kevinnaoko/Amplifier-Circuit/Perancangan Amplifier.pdf

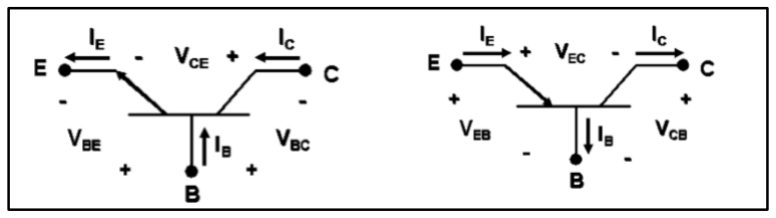
[picture p1: figure]
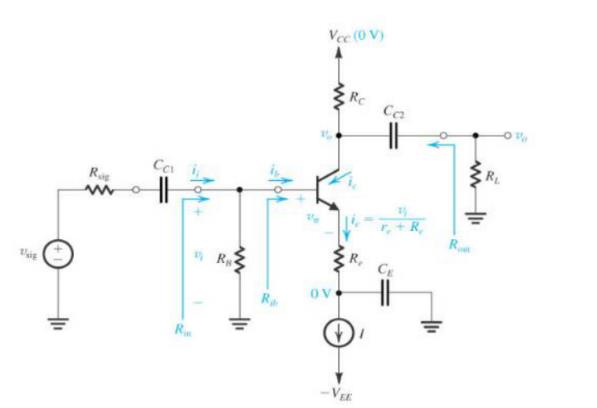
[picture p2: figure]

Laporan Praktikum - Laboratorium Dasar Teknik Elektro – STEI ITB 1

MODUL 4 DESAIN PENGUAT

Kevin Naoko (13218046)
Asisten: Moh. Tamamul Firdaus /13217062 Tanggal Percobaan: 11/03/2020 EL2205-Praktikum Elektronika
Laboratorium Dasar Teknik Elektro - Sekolah Teknik Elektro dan Informatika ITB

Abstrak

Abstrak Pada modul ini akan dilakukan perancangan desain rangkaian penguat menggunakan transistor 2N2222 dengan spesifikasi RIN = 1kΩ, ROUT = 300Ω, serta gain tanpa load = 30dB = 31.6 V/V. Pertama, dilakukan terlebih dahulu pemilihan konfigurasi penguat yang diinginkan. Kelompok ini memilih konfigurasi common emitter dengan kapasitor bypass yang diserikan dengan common emitter tanpa kapasitor bypass. Setelah dilakukan perhitungan, dilakukan simulasi di LTSpice untuk mengkonfirmasi hasil perhitungan, merangkai di breadboard, lalu merealisasikan desain di PCB. Setelah menguji rangkaian kami, didapatkan bahwa nilai RIN sesuai, ROUT melenceng menjadi 350Ω, dan gain sesuai.

Kata kunci: Desain, 2N2222, CE-CE, Gain, RIN,

ROUT.

### 1. PENDAHULUAN

Modul ini bertujuan agar praktikan dapat
merancang | sebuah | penguat | berdasarkan
pengetahuan komprehensif yang telah didapatkan pada percobaan sebelumnya. Untuk memenuhi tujuan ini, akan dilakukan prosedur percobaan sebagai berikut.

Pertama, dilakukan terlebih dahulu pemilihan konfigurasi penguat yang diinginkan. Kelompok ini memilih konfigurasi common emitter dengan kapasitor bypass yang diserikan dengan common emitter tanpa kapasitor bypass. Setelah dilakukan perhitungan, dilakukan simulasi di LTSpice untuk
mengkonfirmasi | hasil | perhitungan, | akan
dilanjutkan dengan pembelian komponen yang diperlukan di Anam Electronics, dan membuat rangkaian purwarupa di breadboard. Setelah dikonfirmasi di breadboard, praktikan perlu mendesain PCB dengan software Eagle, lalu mencetak PCB tersebut dan merangkai rangkaian akhir di PCB dengan komponen yang telah dibeli. Dan terakhir, akan dilakukan pengujian untuk terakhir kalinya terhadap nilai RIN, ROUT, dan gain dari rangkaian.

### 2. STUDI PUSTAKA

### 2.1 TRANSISTOR BJT

BJT ialah semikonduktor yang menggunakan elektron dan hole charge carriers. Pada umumnya,

BJT digunakan sebagai amplifier [1]. Terdapat dua jenis BJT, yaitu jenis NPN dan PNP. Notasi dari kedua jenis BJT tersebut dapat dilihat dibawah ini.

Gambar 2-1 (kiri). BJT tipe NPN [1] Gambar 2-2 (kanan). BJT tipe PNP [1]
BJT memiliki 3 kaki yang dilabel sebagai B, E, dan
C. Ketiga kaki tersebut memiliki arus yang saling
berhubungan | secara | matematis. | Hubungan
tersebut dapat dilihat dibawah ini [2]
| β = IC IB | ; β = α 1 − α
| α = IC IE | ; α = β β + 1

Pada modul ini, akan digunakan BJT bertipe NPN dalam rangkaian penguat.

### 2.2 PENGUAT COMMON EMITTER

Konfigurasi ini memiliki resistansi input yang sedang, transkonduktansi yang tinggi, resistansi output yang tinggi dan memiliki penguatan arus dan tegangan yang tinggi. Konfigurasi ini dapat dilihat pada gambar dibawah ini

Gambar 2-3. Rangkaian CE dengan RE [1]

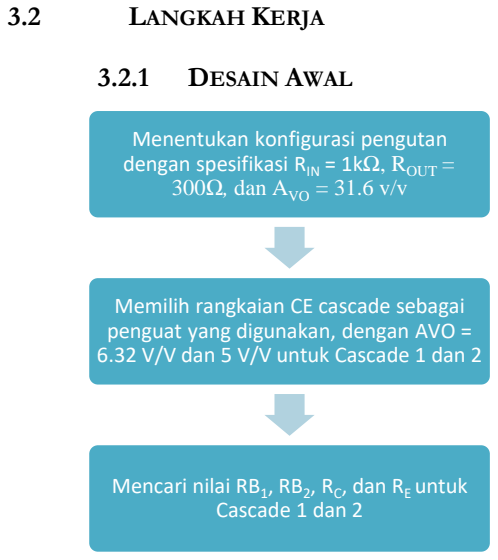
[picture p3: figure]
3.2 LANGKAH KERJA; 3.2.1 DESAIN AWAL; Menentukan konfigurasi pengutan dengan spesifikasi RIN = 1kΩ, ROUT = 300Ω, dan AVO = 31.6 v/v; Memilih rangkaian CE cascade sebagai penguat yang digunakan, dengan AVO =; Mencari nilai RB1; , dan RE untuk Cascade 1 dan 2
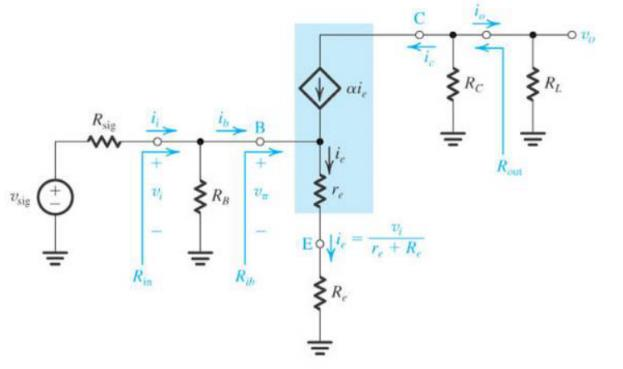
[picture p4: figure]
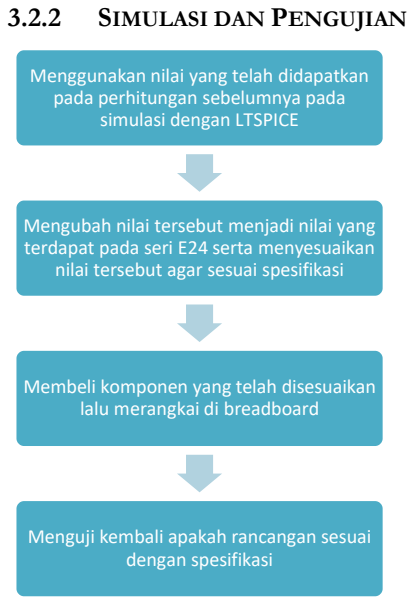
[picture p5: figure]
3.2.2 SIMULASI DAN PENGUJIAN; Menggunakan nilai yang telah didapatkan pada perhitungan sebelumnya pada simulasi dengan LTSPICE; nilai tersebut agar sesuai spesifikasi; Membeli komponen yang telah disesuaikan lalu merangkai di breadboard; Menguji kembali apakah rancangan sesuai dengan spesifikasi

Laporan Praktikum - Laboratorium Dasar Teknik Elektro – STEI ITB 2

Analisis DC

Dari KVL dan KCL, dapat diturunkan beberapa rumus umum sebagai berikut

VE = RE ∙ IE ≈ RE ∙ IC

VB = VE + VBE

VRB1

VRB2

=

RB1

RB2

Analisis AC

Untuk melakukan analisis AC, rangkaian dapat diubah menjadi rangkaian model T seperti gambar dibawah, untuk mencari besaran seperti Rin, Rout, AVO, dsb

Gambar 2-4. Model π dari gambar 2-2 [2]
Dari gambar 2-3, dapat dicari beberapa besaran dibawah ini [2]

re =

VT
IE

=

∝ VT
IC

RB2 ≤

β ∙ RE
re

AVO =

RC
RE + re

IC =

VCC − VCE
RE + re

RIN = RB1

||RB2

||re

Ro = RC

### 3. METODOLOGI

### 3.1 KOMPONEN DAN ALAT

1. Sumber Tegangan DC
2. Generator Sinyal
3. PCB
4. Resistor 100Ω (4 buah)
5. Resistor 150Ω (4 buah)
6. Resistor 1kΩ (1 buah)
7. Resistor 1.2kΩ (1 buah)
8. Resistor 1.5Ω (1 buah)
9. Resistor 3kΩ (1 buah)
10. Resistor 3.3kΩ (1 buah)
11. Resistor 12kΩ (1 buah)
12. Kapasitor 10µF (1 buah)
13. Transistor 2N2222 (1 buah)
14. Kabel Jumper (4 buah)

6.32 V/V dan 5 V/V untuk Cascade 1 dan 2

Mengubah nilai tersebut menjadi nilai yang terdapat pada seri E24 serta menyesuaikan

Laporan Praktikum - Laboratorium Dasar Teknik Elektro – STEI ITB 3

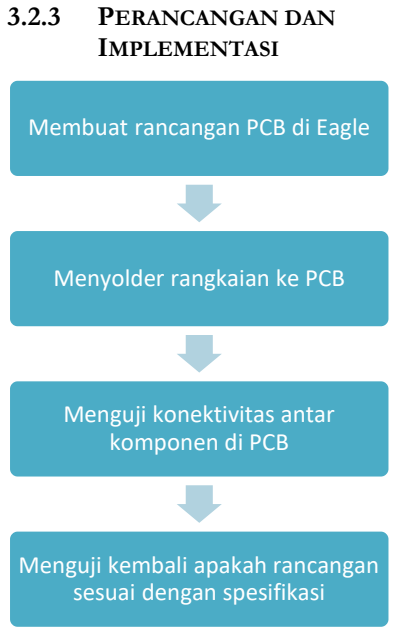
[picture p6: figure]
3.2.3 PERANCANGAN DAN IMPLEMENTASI; Membuat rancangan PCB di Eagle; Menyolder rangkaian ke PCB; Menguji konektivitas antar komponen di PCB; Menguji kembali apakah rancangan sesuai dengan spesifikasi

### 4. DESAIN

### 4.1 PERHITUNGAN AWAL

Diambil beberapa besaran awal dari hasil percobaan modul 2. Besaran tersebut tertera pada tabel dibawah ini.

Tabel 4-1. Nilai dari beberapa Besaran Dalam Proses Desain

Variabel | Cascade 1 | Cascade 2
VCC | 10V
IC (active) | 2.2mA | 2.5mA
IC (sat) | 5mA
VCE (sat) | 14mV
β | 245 | 285
RIN | 1kΩ | ~
ROUT | ~ | 300Ω
AVO | 6.32 V/V | 5 V/V
AVO Total | 30dB = 31.6 V/V

Lalu, akan digunakan rumusan dari subbab 2.2 untuk mendesain amplifier sesuai spesifikasi yang diminta.

Cascade Kedua

Mencari re

re =

∝ VT
IC

=

25m
2.5m

∙

β
β + 1

= 9.96 ≈ 10Ω

Menggunakan AVO spesifikasi untuk mencari RE

AVO =

RC
RE + re

5 =

300
RE + 10

RE = 50Ω

Menggunakan RE yang telah didapat untuk mencari rentang nilai RB2
| RB2 ≤ β ∙ RE re

RB2 ≤

| 285 ∙ 50
| 10 RB2 ≤ 1425Ω

Menyesuaikan dengan resistor yang terdapat di pasaran, nilai RB2 menjadi

| RB2 = 1.3kΩ

Menggunakan KVL untuk mencari VE, VRB2, dan

VRB1

| VE ≈ RE ∙ IC

VE = 50 ∙ 2.5m = 0.125V

VB = VRB2 = 0.125 + 0.7 = 0.825V

VRB1 = VCC − VRB2 = 10 − 0.825 = 9.125 V

Menggunakan perbandingan tegangan untuk mencari nilai RB1 dan RB2 yang sesuai

| VRB1 VRB2 = RB1 RB2
| 9.125 0.825 = RB1 1.3k

RB1 = 14378Ω

Menyesuaikan dengan resistor yang terdapat di pasaran, nilai RB1 menjadi

| RB1 = 13kΩ

Cascade Pertama

Mencari re re =
VT IC = | 25m 2.2m ∙ β β + 1 = 11.36Ω

Menggunakan AVO spesifikasi untuk mencari RC

AVO =

| VB VC = RC re
| 6.64 = RC
| 11.36
RC = 75.430 ≈ 75Ω

Menggunakan nilai saturasi dari karakteristik BJT untuk mencari RE

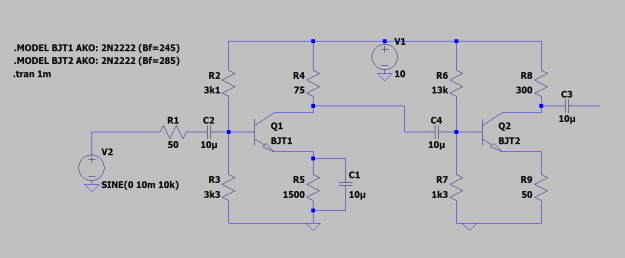
[picture p7: figure]
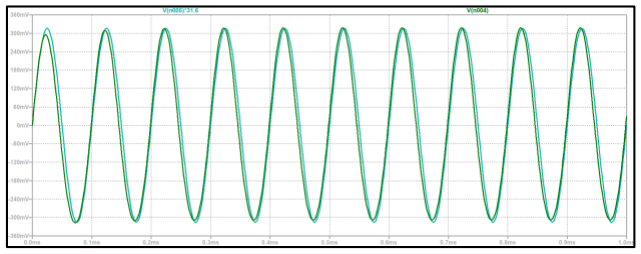
[picture p8: figure]
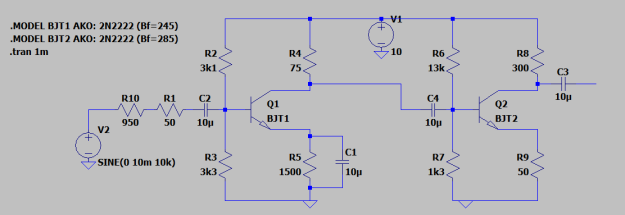
[picture p9: figure]
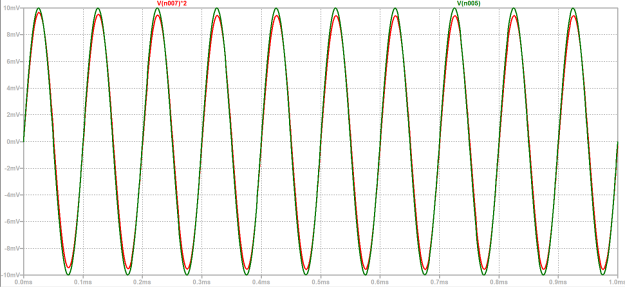
[picture p10: figure]
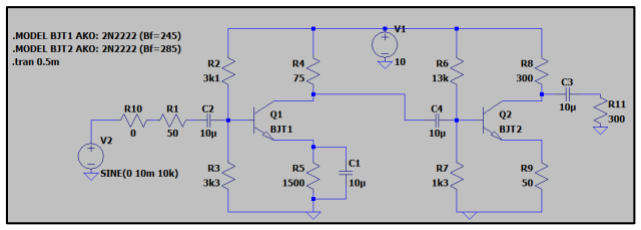
[picture p11: figure]

Laporan Praktikum - Laboratorium Dasar Teknik Elektro – STEI ITB 4

IC(sat) =

VCC − VCE(sat)
RE + re

=

10 − 0.014
RE +11.36

RE = 1985.84 ≈ 2kΩ

Menggunakan RE yang telah didapat untuk mencari rentang nilai RB2

RB2 ≤

β ∙ RE
re

RB2 ≤

245 ∙ 2k
11.36
RB2 ≤ 43133

Nilai ini tidak mungkin digunakan langsung, karena spesifikasi meminta RIN = 1000Ω, maka perlu dencari RB sehingga memenuhi spesifikasi RIN yang diberikan, asal tidak melewati batas maksimum RB2

RIN = RB1

||RB2

||re

1k = RB||11.36

RB = 1557Ω = 1.6kΩ

Menggunakan KVL untuk mencari VE dan perbandingan VRB2 dengan VRB1, lalu mencari nilai RB1 dan RB2 yang ada di pasar

VE ≈ RE ∙ IC

VE = 2k ∙ 2.2m = 4.4V

VB = VRB2 = 4.4 + 0.7 = 5.1V

VRB1 = VCC − VRB2 = 10 − 5.1 = 4.9V

VRB1

VRB2

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
RB2 = 1.0408RB1

Pilih RB1 = 3.1k, menyesuaikan dengan resistor yang terdapat di pasaran, nilai RB2 menjadi

RB2 = 3k226 ≈ 3k3Ω

dengan RB1 = 3k1

Tabel 4-2. Rekap Nilai Resistor yang Digunakan
| Cascade 1 | Cascade 2
RB1 | 3.1k | 13k
RB2 | 3.3k | 1.3k
RE | 2k | 50
RC | 75 | 300

### 4.2 SIMULASI

Gambar 4-1. Rangkaian Simulasi pada LTSpice

Gambar 4-2. Hasil simulasi waveform pada LTSpice Dapat dilihat pada gambar 4-2 bahwa VIN dengan
RVAR | 1000Ω = ½ VIN | tanpa RVAR. Hal ini
menunjukkan bahwa pada simulasi LTSpice, RIN rangkaian ialah 1kΩ. Namun terdapat perbedaan sedikit pada grafik, yang disebabkan karena rounding nilai resistor agar sesuai dengan E24

Gambar 4-3. Rangkaian yang digunakan untuk menguji

RIN

Gambar 4-4. Hasil pengujian RIN pada LTSpice (Merah = Vin awal; Hijau = Vin dengan Rsig)

Gambar 4-3. Rangkaian yang digunakan untuk menguji

ROUT

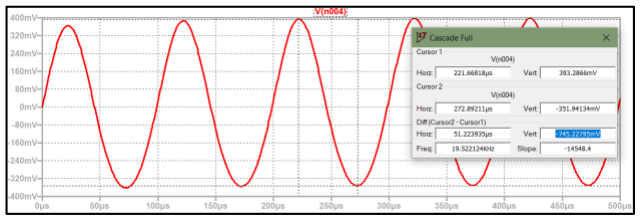
[picture p12: figure]
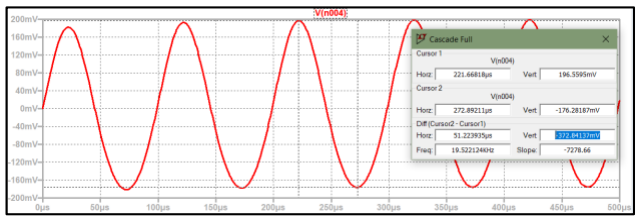
[picture p13: figure]
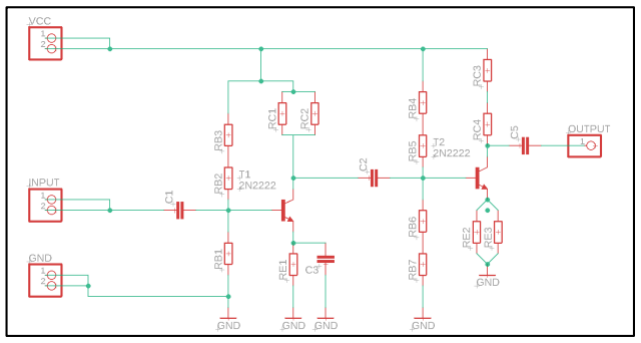
[picture p14: figure]
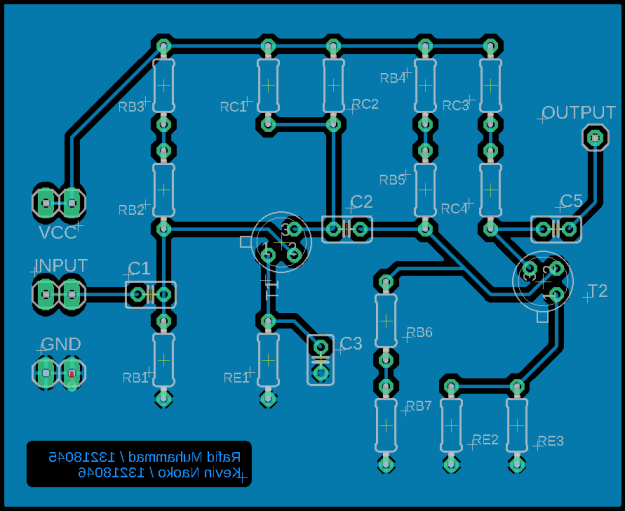
[picture p15: figure]
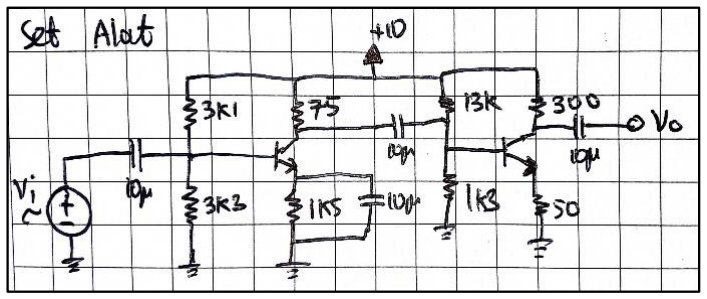
[picture p16: figure]

Laporan Praktikum - Laboratorium Dasar Teknik Elektro – STEI ITB 5

Gambar 4-6 VOUT Tanpa Load

Gambar 4-7. VOUT dengan Load= 300Ω
Dapat dilihat pada gambar 4-6 dan 4-7 bahwa VOUT dengan load 300Ω = ½ VOUT tanpa load. Hal ini menunjukkan bahwa pada simulasi LTSpice, ROUT rangkaian ialah 300Ω.

### 4.3 PERANCANGAN PCB

Gambar 4-8. Skematik PCB pada Eagle

Gambar 4-9. Desain PCB pada Eagle

### 4.4 DAFTAR KEBUTUHAN KOMPONEN

Tabel 4-1. Detail Komponen yang Digunakan

Jenis | Besar / Tipe | Jumlah
Resistor | 100Ω | 4
| 150Ω | 4
| 1kΩ | 1
| 1.2kΩ | 1
| 1.5kΩ | 1
| 3kΩ | 1
| 3.3kΩ | 1
| 12kΩ | 1
Kapasitor | 10uF | 4
Transistor | 2N2222 | 2
PCB | | 1
Total | | 20
Biaya Total | | Rp. 46000

### 5. HASIL DAN ANALISIS

### 5.1 SETUP PENGUJIAN

Dilakukan pengujian dengan breadboard terlebih dahulu untuk memverifikasi desain yang telah dibuat. Sayangnya praktikan tidak melakukan
dokumentasi | breadboard, | namun | akan
dilampirkan setting komponen untuk dirancang ke breadboard tersebut. Dibawah ini akan ditunjukkan gambar tersebut serta gambar PCB yang telah selesai dirancang.

Gambar 5-1. Set alat pada Breadboard

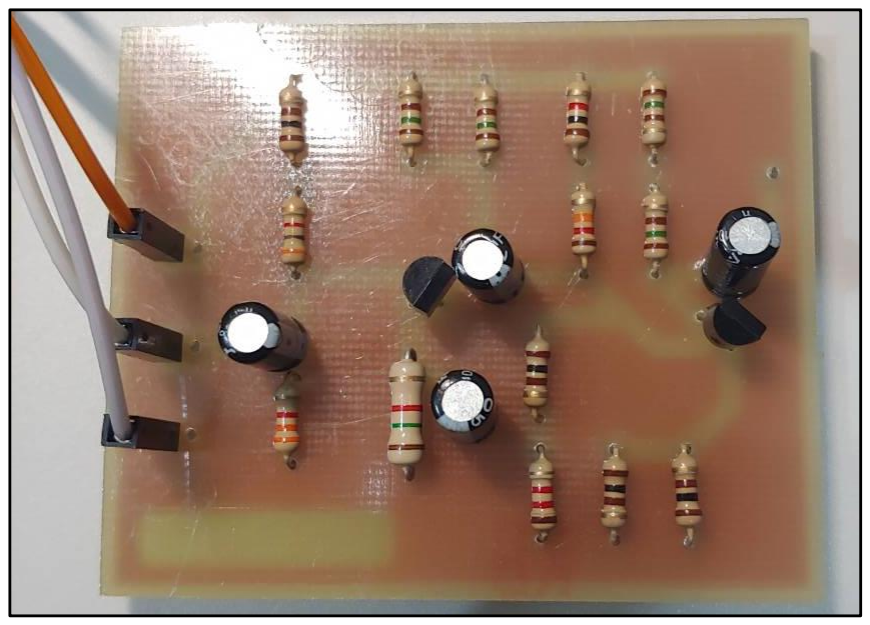
[picture p17: figure]
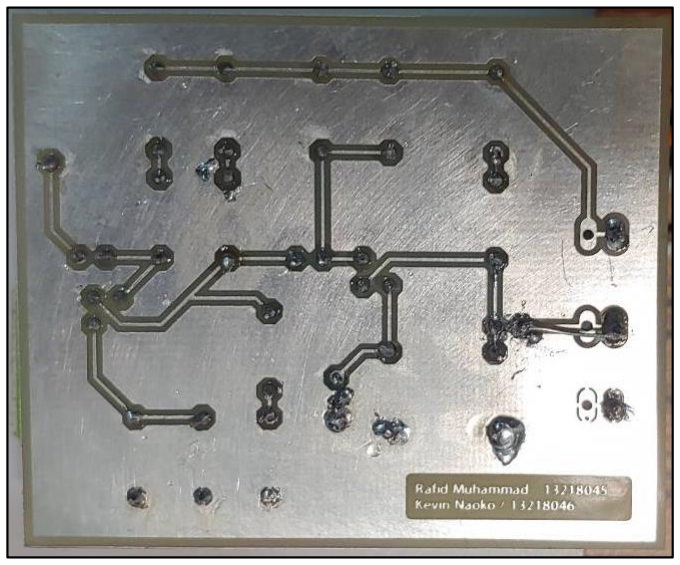
[picture p18: figure]
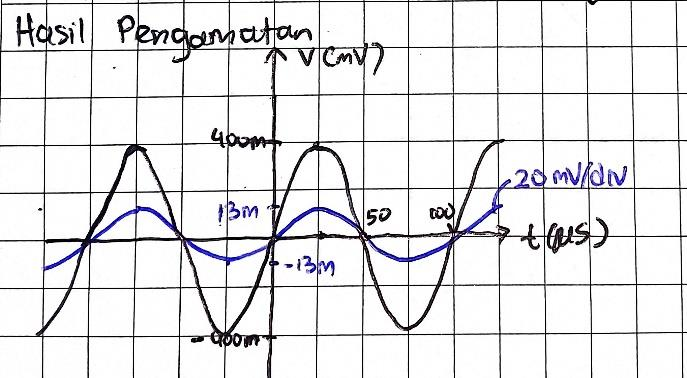
[picture p19: figure]

Laporan Praktikum - Laboratorium Dasar Teknik Elektro – STEI ITB 6

Gambar 5-2. Rangkaian yang Telah Direalisasi di PCB

Gambar 5-3. Bagian Belakang PCB

### 5.2 PENGUJIAN GAIN PENGUAT

Gambar 5-4. Pengamatan Dengan Osiloskop Dengan:

VOPP eksak = 820 mVpp, dan

VIN eksak = 26 mVpp

Gain yang didapat = 31.54 V/V

### 5.3 PENGUJIAN RESISTANSI INPUT

Dengan menghubungkan RVAR diantara generator sinyal dan kapasitor C1 seperti percobaan pada modul 3, lalu mengubah nilai RVAR sehingga VIN menjadi ½ VIN awal, dapat dicari resistansi input dari suatu rangkaian amplifier

Hasil pengujian menunjukkan bahwa RIN terukur sebesar 1000Ω.

### 5.4 PENGUJIAN RESISTANSI OUTPUT

Dengan menghubungkan RVAR ke ujung kapasitor C4 seperti percobaan pada modul 3, lalu mengubah nilai RVAR sehingga VO = ½ VO awal, dapat dicari resistansi output dari suatu rangkaian amplifier.

Hasil pengujian menunjukkan bahwa RIN terukur sebesar 350Ω.

### 5.5 ANALISIS

Gain input total yang didapatkan dari hasil percobaan ini ialah 31.54 V/V. Hasil yang didapatkan sangat memuaskan, karena hanya berbeda sedikikit dengan gain yang diminta dari spesifikasi (31.6 V/V), dan dapat dikatakan memiliki gain yang sama seperti spesifikasi.

Hasil pengujian RIN juga membuahkan hasil yang memuaskan. Pengujian dengan RVAR menunjukkan bahwa resistansi input yang dimiliki oleh rangkaian ini sesuai dengan spesifikasi, yakni tepat 1kΩ

Namun terdapat sedikit deviasi pada nilai resistansi output rangkaian ini. ROUT yang terukur pada proses pengujian ialah 350Ω, 50Ω lebih besar dari spesifikasi. Perubahan nilai ini diduga karena terdapat nilai nilai resistor yang diubah menjadi nilai yang terdapat di E24 untuk memudahkan pembelian resistor.

### 6. KESIMPULAN

1. Praktikan | menggunakan | desain
konfigurasi common emitter dengan RE yang dibypass oleh kapasitor yang diserikan dengan konfigurasi common emitter dengan
RE | dengan | besaran | resistor | yang
digunakan dapat dilihat di bagian akhir subbab 4.1.
2. Hasil simulasi di LTSpice menunjukkan bahwa nilai resistansi yang digunakan sudah cocok dengan spesifikasi yang diminta. Namun terdapat sedikit deviasi pada nilai ROUT pada percobaan riil nya sebesar 50Ω menjadi 350Ω. Nilai RIN dan AVO nya sudah sesuai spesifikasi, yaitu 1kΩ dan 30dB. Hal ini disebabkan karena penggunaan resistor yang berbeda dari hasil perhitungan dan juga kondisi rangkaian saat pengujian yang tidak ideal.
3. Praktikan memahami cara membuat desain amplifier yang baik.

Laporan Praktikum - Laboratorium Dasar Teknik Elektro – STEI ITB 7

DAFTAR PUSTAKA

[1] Mervin T Hutabarat, Petunjuk Praktikum Elektronika EL2205, Institut Teknologi Bandung, Bandung, 2020
[2] Adel S. Sedra dan Kennet C. Smith, Microelectronic Circuits, Oxford University Press, USA, 1997.

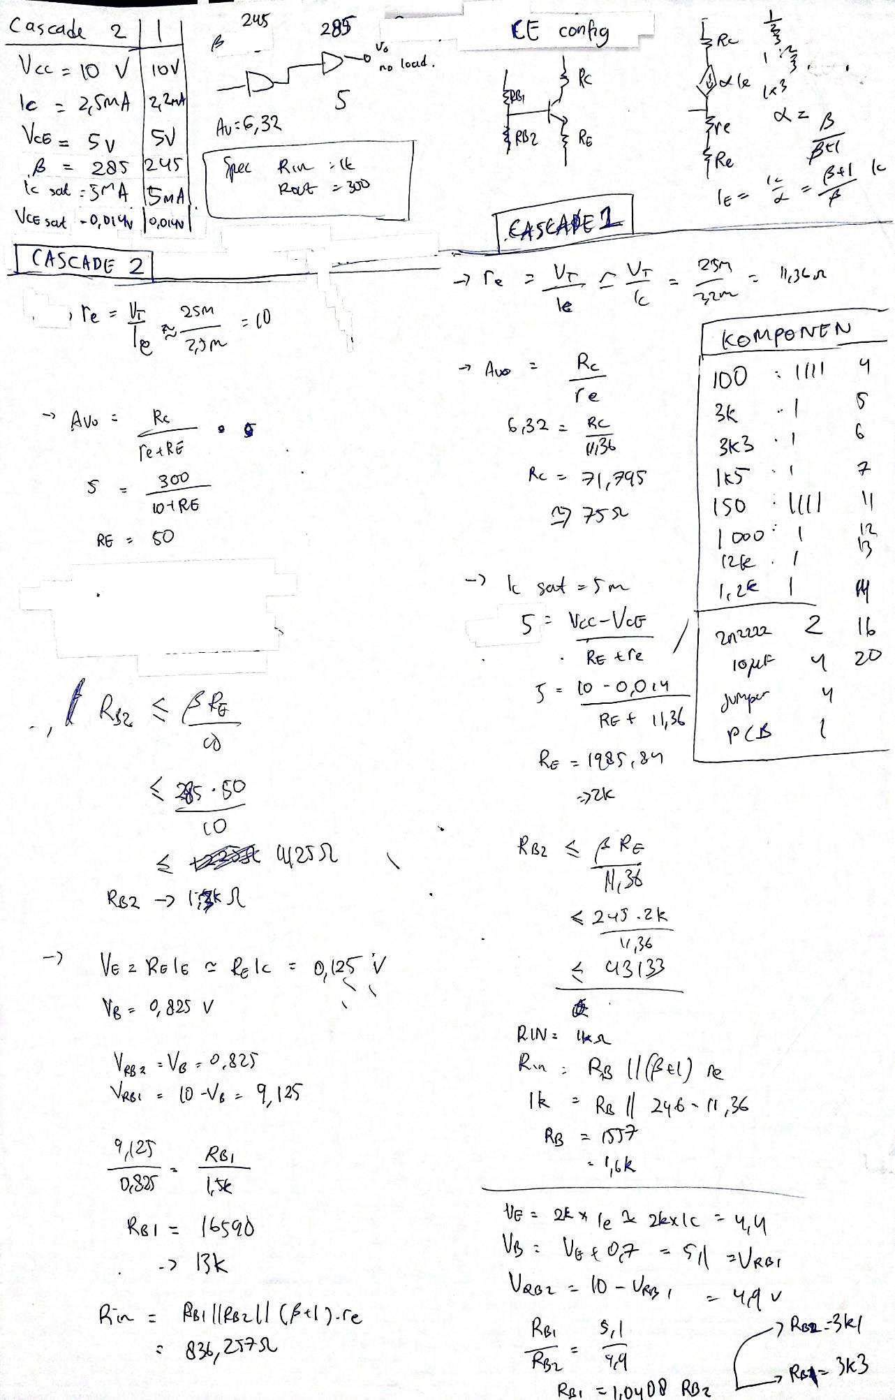
[picture p20: figure]

Laporan Praktikum - Laboratorium Dasar Teknik Elektro – STEI ITB 8

LAMPIRAN

Lampiran A. Perhitungan Setelah Revisi (Versi yang lebih rapi dapat dilihat di subbab 4-1.) Untuk hasil simulasi serta PCB, dapat dilihat di subbab 4.2 – 4.4
