kevinnaoko/Amplifier-Circuit/Schematics/Simulasi Rangkaian.asc

C1: cap; 10µ
C2: cap; 10µ
C3: cap; 10µ
C4: cap; 10µ
Q1: npn; BJT1
Q2: npn; BJT2
R1: res; 50
R2: res; 3k1
R3: res; 3k3
R4: res; 75
R5: res; 1500
R6: res; 13k
R7: res; 1k3
R8: res; 300
R9: res; 50
V1: voltage; 10
Vin: voltage; SINE(0 10m 10k)
Named nets: 0, Vout
.MODEL BJT1 AKO: 2N2222 (Bf=245)
.MODEL BJT2 AKO: 2N2222 (Bf=285)
.tran 1m
