kevinnaoko/Amplifier-Circuit/Schematics/PCB Design.sch

## EAGLE design Schematics/PCB Design.sch (2021-04-16)

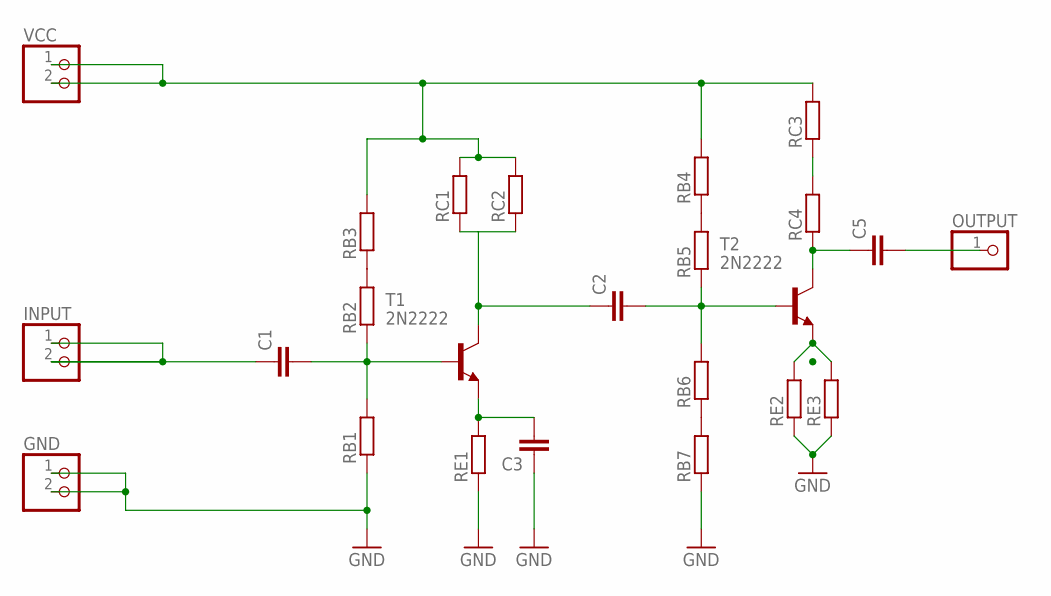
[picture p21: schematic PCB Design.sch]

Parts:
C1, C2, C3, C5: C-EU025-025X050; C025-025X050
GND: PINHD-1X2; 1X02
INPUT: PINHD-1X2; 1X02
OUTPUT: PINHD-1X1; 1X01
RB1, RB2, RB3, RB4, RB5, RB6, RB7: R-EU_0204/7; 0204/7
RC1, RC2, RC3, RC4: R-EU_0204/7; 0204/7
RE1, RE2, RE3: R-EU_0204/7; 0204/7
T1, T2: 2N2222; TO18
VCC: PINHD-1X2; 1X02

Connections:
GND: C3.1, GND.1, GND.2, RB1.1, RB7.1, RE1.1, RE2.1, RE3.1
INPUT: C1.1, INPUT.1, INPUT.2
unnamed: C1.2, RB1.2, RB2.1, T1.2 (B)
unnamed: C3.2, RE1.2, T1.1 (E)
unnamed: C2.2, RB5.1, RB6.2, T2.2 (B)
unnamed: RB2.2, RB3.1
unnamed: C2.1, RC1.1, RC2.1, T1.3 (C)
unnamed: RE2.2, RE3.2, T2.1 (E)
unnamed: RB4.1, RB5.2
unnamed: RC3.1, RC4.2
unnamed: RB6.1, RB7.2
unnamed: C5.1, RC4.1, T2.3 (C)
unnamed: C5.2, OUTPUT.1
VCC: RB3.2, RB4.2, RC1.2, RC2.2, RC3.2, VCC.1, VCC.2
